ystark/OpenLog/hardware/OpenLog.brd

## EAGLE design hardware/OpenLog.brd (2015-05-08)

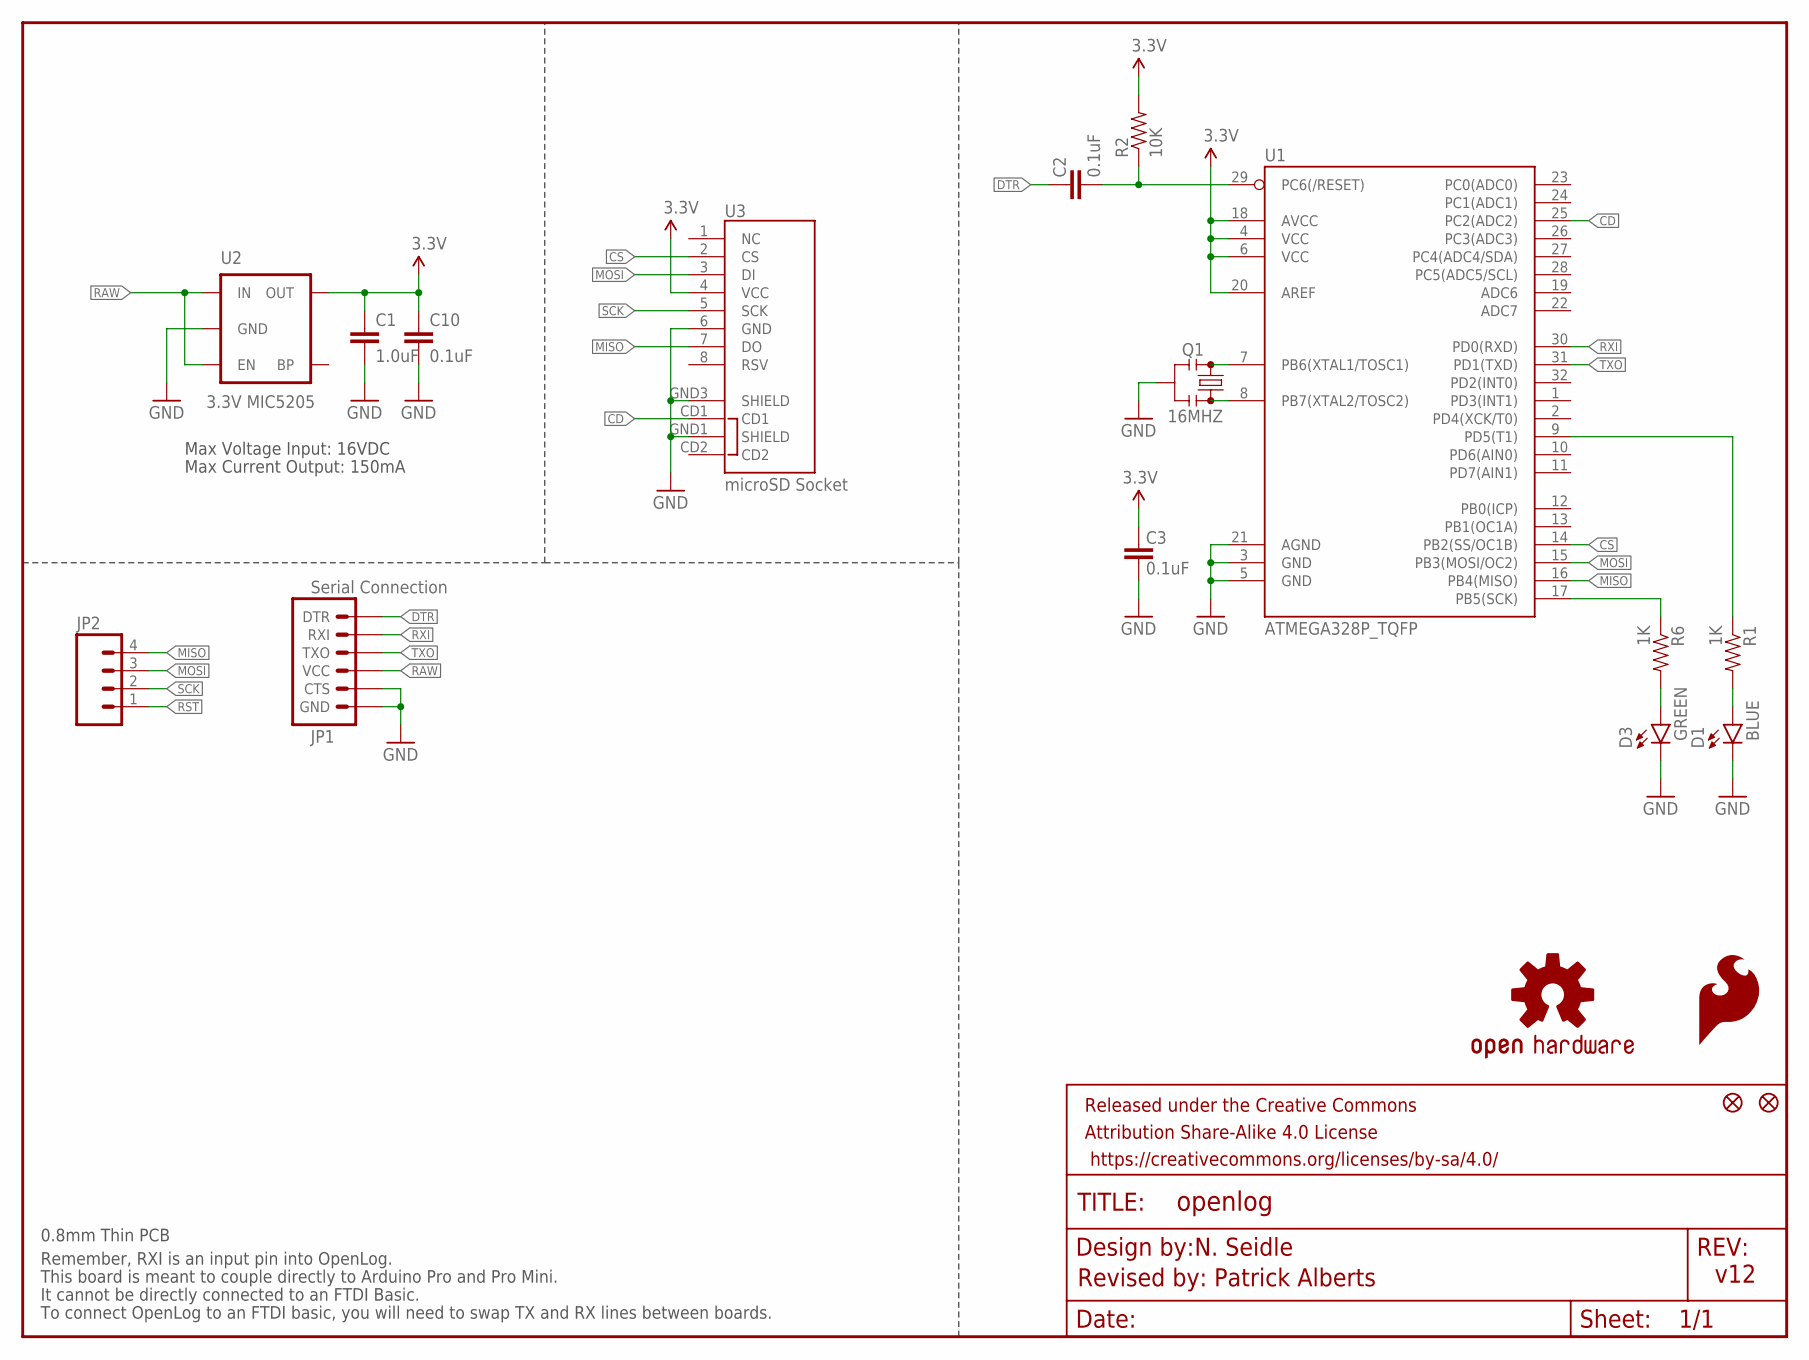
[picture p1: schematic OpenLog.sch]

Parts:
C1: 1.0uF; 0603-CAP
C2, C3, C10: 0.1uF; 0603-CAP
D1: BLUE; LED-0603
D3: GREEN; LED-0603
FID1, FID2: FIDUCIALUFIDUCIAL; MICRO-FIDUCIAL
FRAME1: FRAME-LETTER; CREATIVE_COMMONS
JP1: Serial Connection; 1X06
JP2: M04PTH; 1X04
LOGO1: SFE_LOGO_FLAME.1_INCH; SFE_LOGO_FLAME_.1
LOGO2: OSHW-LOGOS; OSHW-LOGO-S
Q1: 16MHZ; RESONATOR-SMD
R1, R6: 1K; 0603-RES
R2: 10K; 0603-RES
U1: ATMEGA328P_TQFP; TQFP32-08
U2: 3.3V MIC5205; SOT23-5
U3: microSD Socket; MICROSD_1:1

Connections:
3.3V: C1.1, C3.2, C10.1, R2.2, U1.4 (VCC), U1.6 (VCC), U1.18 (AVCC), U1.20 (AREF), U2.5 (OUT), U3.4 (VCC)
CD: U1.25 (PC2(ADC2)), U3.CD1
CS: U1.14 (PB2(SS/OC1B)), U3.2 (CS)
DTR: C2.2, JP1.1 (DTR)
GND: C1.2, C3.1, C10.2, D1.C, D3.C, JP1.5 (CTS), JP1.6 (GND), Q1.2, U1.3 (GND), U1.5 (GND), U1.21 (AGND), U2.2 (GND), U3.6 (GND), U3.GND1 (SHIELD), U3.GND3 (SHIELD)
MISO: JP2.4, U1.16 (PB4(MISO)), U3.7 (DO)
MOSI: JP2.3, U1.15 (PB3(MOSI/OC2)), U3.3 (DI)
unnamed: Q1.1, U1.8 (PB7(XTAL2/TOSC2))
unnamed: Q1.3, U1.7 (PB6(XTAL1/TOSC1))
unnamed: D1.A, R1.2
unnamed: R1.1, U1.9 (PD5(T1))
unnamed: D3.A, R6.2
RAW: JP1.4 (VCC), U2.1 (IN), U2.3 (EN)
RST: C2.1, JP2.1, R2.1, U1.29 (PC6(/RESET))
RXI: JP1.2 (RXI), U1.30 (PD0(RXD))
SCK: JP2.2, R6.1, U1.17 (PB5(SCK)), U3.5 (SCK)
TXO: JP1.3 (TXO), U1.31 (PD1(TXD))

Notes on the sheet:
Max Voltage Input: 16VDC
Max Current Output: 150mA
Remember, RXI is an input pin into OpenLog.
This board is meant to couple directly to Arduino Pro and Pro Mini.
It cannot be directly connected to an FTDI Basic.
To connect OpenLog to an FTDI basic, you will need to swap TX and RX lines between boards.
v12
N. Seidle
Revised by: Patrick Alberts
0.8mm Thin PCB

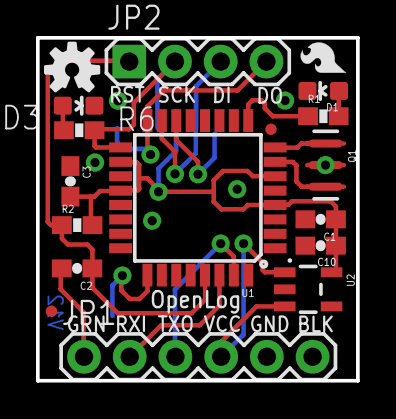
[picture p2: board OpenLog.brd from above]

Board: 2 copper layers, 17.8 x 19.1 mm, 20 parts (1 on the bottom side), 17 nets.
