ystark/OpenLog/(commit log)

2010-09-29 v2.21 ringp fork brought in. Wildcard remove and list commands now work. Remove directory now works! Change directory up/down the tree works again.
    28440 bytes used of 30720.
    ringp brought back many great commands! Thanks ringp!
    rm LOG*.* works
    ls *.TXT works
    cd .. works again
    ls now correctly shows directories first and files following the directories.
    To remove a directory, you have to navigate into that directory. For example:
    >cd TEMP (you are now in TEMP directory)
    >rm -f TEMP (you are now removing TEMP, and you will be pushed back down one level of the tree)
    >ls (shows files and directories where TEMP directory used to be, but TEMP directory should be gone)
    ringp added new comman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
    [OpenLog_v2.pde]
2015-05-05 Rev Changes made
    Updated to current standards
    0603
    Sch
    switched micro sd socket
    [OpenLog.brd, OpenLog.sch]
2015-05-06 Moved Silk
    [OpenLog.brd, OpenLog.sch]
2015-05-07 Initial QC checklist run though
    As in my own, before I actually get one done.
    [OpenLog.brd, OpenLog.sch]
2015-05-07 Added OSHW Logo
    [OpenLog.brd, OpenLog.sch]
2015-05-07 Fixed Version #
    [OpenLog.brd, OpenLog.sch]
2015-05-08 FIxed QC issues
    [OpenLog.sch]
2015-05-08 Fixed QC issues
    [OpenLog.brd]
2015-05-31 Update to the latest SdFat lib and Arduino 1.6.4
